sideridispas/Measuring-PCB/README.md

# Measuring-PCB
Voltage, Current, Temperature and Timestamped measurement board with an Atmega328 as main CPU
