sideridispas/Measuring-PCB/3D/board2.brd.stp

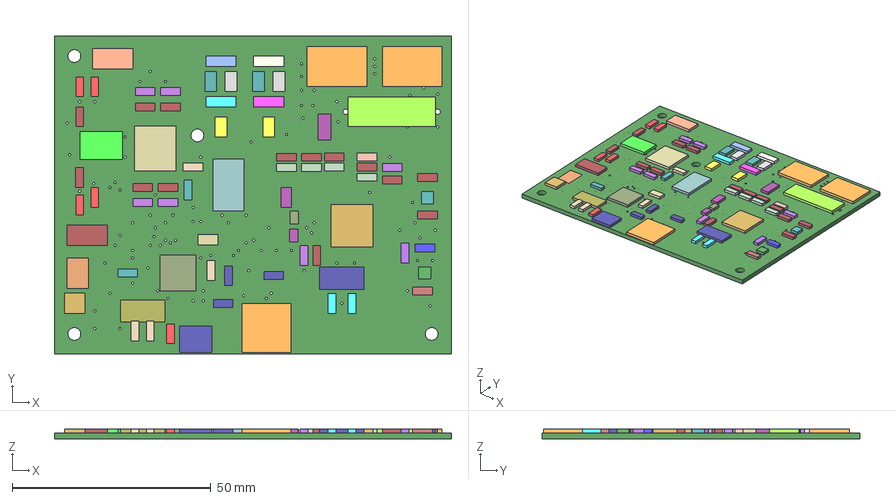
[picture p1: CAD file, 2016-03-25]
3D/board2.brd.stp
100.0 x 80.0 x 2.60 mm
board2.brd_Outline
PHOENIX-TERMINAL-3PIN, PHOENIX-TERMINAL-3PIN_1
SOT95P280X145-6N, ADR3425ARJZ-R7_3
SOP65P780X200-28N, ADS1256IDBT_5
SOIC127P1032X265-16N, ADUM5000ARWZ_7
1X02, AIN6-7_1X02_9
TQFP32-08, ATMEGA328P_TQFP_11
BATTCON_12MM, 3V_13
C3216, 10U_15 x 6
C3216, 0_1U_17 x 14
C3216, 47U_19
C3216, 100P_22 x 4
C3216, 18P_26 x 2
C3216, 1U_47
C3216, 10N_49
C3216, 2_2U_51
C3216, 22P_53 x 4
DS3234, DS3234_58
PAS_5X20, 15A_60
2X3, FEMALE_62
2X04, ISOLATED_CON_2X04_64
1X03, JP1A_1X03_66
1X03, JP1B_1X03_68
1X03, JP2A_1X03_70
1X03, JP2B_1X03_72
SOT95P280X145-5N, LP2985-33DBVT_74
SOIC-16, IC_DIL16-SOIC-16_76
2X04, NON-ISOLATED_CON_2X04_78
HC49U-V, 7_68MHZ_80
HC49U-V, 16MHZ_82
LVK25, 0_005_84
R3216, 4_7K_86 x 5
M3216, 560K_88 x 2
M3216, 5_49M_90 x 2
M3216, 1K_95 x 2
R3216, 100_100 x 3
R3216, 10K_104 x 2
TACTILE-SWITCH-SMD, TAC_SWITCHSMD_108
1X02, RX-TX_1X02_110
SJ, SJ1-RST_SJ_112
SJ, SJ2-SYNC_SJ_114
2TERMINALBLOCK_10MMPITCH, 2PIN_TERMINAL_PCBMOUNT_116 x 2
