sideridispas/Measuring-PCB/(list of files, cad)

Other CAD files:
3D/1X02, AIN6-7_1X02_9.ipt
3D/1X02, RX-TX_1X02_110.ipt
3D/1X03, JP1A_1X03_66.ipt
3D/1X03, JP1B_1X03_68.ipt
3D/1X03, JP2A_1X03_70.ipt
3D/1X03, JP2B_1X03_72.ipt
3D/2TERMINALBLOCK_10MMPITCH, 2PIN_TERMINAL_PCBMOUNT_116.ipt
3D/2X04, ISOLATED_CON_2X04_64.ipt
3D/2X04, NON-ISOLATED_CON_2X04_78.ipt
3D/2X3, FEMALE_62.ipt
3D/Assembly.iam
3D/BATTCON_12MM, 3V_13.ipt
3D/C3216, 0_1U_17.ipt
3D/C3216, 100P_22.ipt
3D/C3216, 10N_49.ipt
3D/C3216, 10U_15.ipt
3D/C3216, 18P_26.ipt
3D/C3216, 1U_47.ipt
3D/C3216, 22P_53.ipt
3D/C3216, 2_2U_51.ipt
3D/C3216, 47U_19.ipt
3D/DS3234, DS3234_58.ipt
3D/HC49U-V, 16MHZ_82.ipt
3D/HC49U-V, 7_68MHZ_80.ipt
3D/IC_names.ipt
3D/LVK25, 0_005_84.ipt
3D/M3216, 1K_95.ipt
3D/M3216, 560K_88.ipt
3D/M3216, 5_49M_90.ipt
3D/MC4_plug.ipt
3D/New3DTry/1X02, RX-TX_1X02_119.ipt
3D/New3DTry/1X02_NO_SILK, AIN6-7_1X02_NO_SILK_9.ipt
3D/New3DTry/1X03, JP1A_1X03_69.ipt
3D/New3DTry/1X03, JP1B_1X03_71.ipt
3D/New3DTry/1X03, JP2A_1X03_73.ipt
3D/New3DTry/1X03, JP2B_1X03_75.ipt
3D/New3DTry/1X04_NO_SILK_ALL_ROUND, D0-D3_1X04_NO_SILK_ALL_ROUND_59.ipt
3D/New3DTry/2X04, ISOLATED_CON_2X04_67.ipt
3D/New3DTry/2X04, NON-ISOLATED_CON_2X04_83.ipt
3D/New3DTry/2X3, FEMALE_65.ipt
3D/New3DTry/BATTCON_12MM, 3V_13.ipt
3D/New3DTry/C3216, 0_1U_17.ipt
3D/New3DTry/C3216, 100P_22.ipt
3D/New3DTry/C3216, 10N_49.ipt
3D/New3DTry/C3216, 10U_15.ipt
3D/New3DTry/C3216, 18P_26.ipt
3D/New3DTry/C3216, 1U_47.ipt
3D/New3DTry/C3216, 22P_53.ipt
3D/New3DTry/C3216, 2_2U_51.ipt
3D/New3DTry/C3216, 47U_19.ipt
3D/New3DTry/CHIPLED_0805, LED1_CHIPLED_0805_77.ipt
3D/New3DTry/DS3234, DS3234_61.ipt
3D/New3DTry/HC49U-V, 16MHZ_87.ipt
3D/New3DTry/HC49U-V, 7_68MHZ_85.ipt
3D/New3DTry/LVK25, 0_005_89.ipt
3D/New3DTry/M3216, 1K_100.ipt
3D/New3DTry/M3216, 560K_93.ipt
3D/New3DTry/M3216, 5_49M_95.ipt
3D/New3DTry/OldVersions/board2.brd.0007.iam
3D/New3DTry/OldVersions/board2.brd.0017.iam
3D/New3DTry/PAS-PHOENIXTERMINAL-2PIN-10_16MM, PAS-PHOENIXTERMINAL2PIN-10_16MM_123.ipt
3D/New3DTry/PAS_5X20, 15A_63.ipt
3D/New3DTry/PHOENIX-TERMINAL-3PIN, PHOENIX-TERMINAL-3PIN_1.ipt
3D/New3DTry/R3216, 100_105.ipt
3D/New3DTry/R3216, 10K_109.ipt
3D/New3DTry/R3216, 1K_113.ipt
3D/New3DTry/R3216, 4_7K_91.ipt
3D/New3DTry/SJ, RST_SJ_117.ipt
3D/New3DTry/SJ, SYNC_SJ_121.ipt
3D/New3DTry/SOIC-16, IC_DIL16-SOIC-16_81.ipt
3D/New3DTry/SOIC127P1032X265-16N, ADUM5000ARWZ_7.ipt
3D/New3DTry/SOP65P780X200-28N, ADS1256IDBT_5.ipt
3D/New3DTry/SOT95P280X145-5N, LP2985-33DBVT_79.ipt
3D/New3DTry/SOT95P280X145-6N, ADR3425ARJZ-R7_3.ipt
3D/New3DTry/TACTILE_SWITCH_TALL, SWITCH-MOMENTARY-2SMD-4_115.ipt
3D/New3DTry/TQFP32-08, ATMEGA328P_TQFP_11.ipt
3D/New3DTry/board2.brd.iam
3D/New3DTry/board2.brd_Outline.ipt
3D/OldVersions/Assembly.0001.iam
3D/OldVersions/board2.brd.0001.ipt
3D/OldVersions/board2.brd.0002.iam
3D/OldVersions/box_base.0001.ipt
3D/OldVersions/fuse.0001.ipt
3D/OldVersions/headers.0001.ipt
3D/PAS_5X20, 15A_60.ipt
3D/PHOENIX-TERMINAL-3PIN, PHOENIX-TERMINAL-3PIN_1.ipt
3D/R3216, 100_100.ipt
3D/R3216, 10K_104.ipt
3D/R3216, 4_7K_86.ipt
3D/SJ, SJ1-RST_SJ_112.ipt
3D/SJ, SJ2-SYNC_SJ_114.ipt
3D/SOIC-16, IC_DIL16-SOIC-16_76.ipt
3D/SOIC127P1032X265-16N, ADUM5000ARWZ_7.ipt
3D/SOP65P780X200-28N, ADS1256IDBT_5.ipt
3D/SOT95P280X145-5N, LP2985-33DBVT_74.ipt
3D/SOT95P280X145-6N, ADR3425ARJZ-R7_3.ipt
3D/TACTILE-SWITCH-SMD, TAC_SWITCHSMD_108.ipt
3D/TQFP32-08, ATMEGA328P_TQFP_11.ipt
3D/board2.brd.iam
3D/board2.brd.ipt
3D/board2.brd_Outline.ipt
3D/box_base.ipt
3D/button.ipt
3D/connectors.ipt
3D/crystals.ipt
3D/fuse.ipt
3D/headers.ipt
