sideridispas/Measuring-PCB/boardv2.3_schematic.pdf

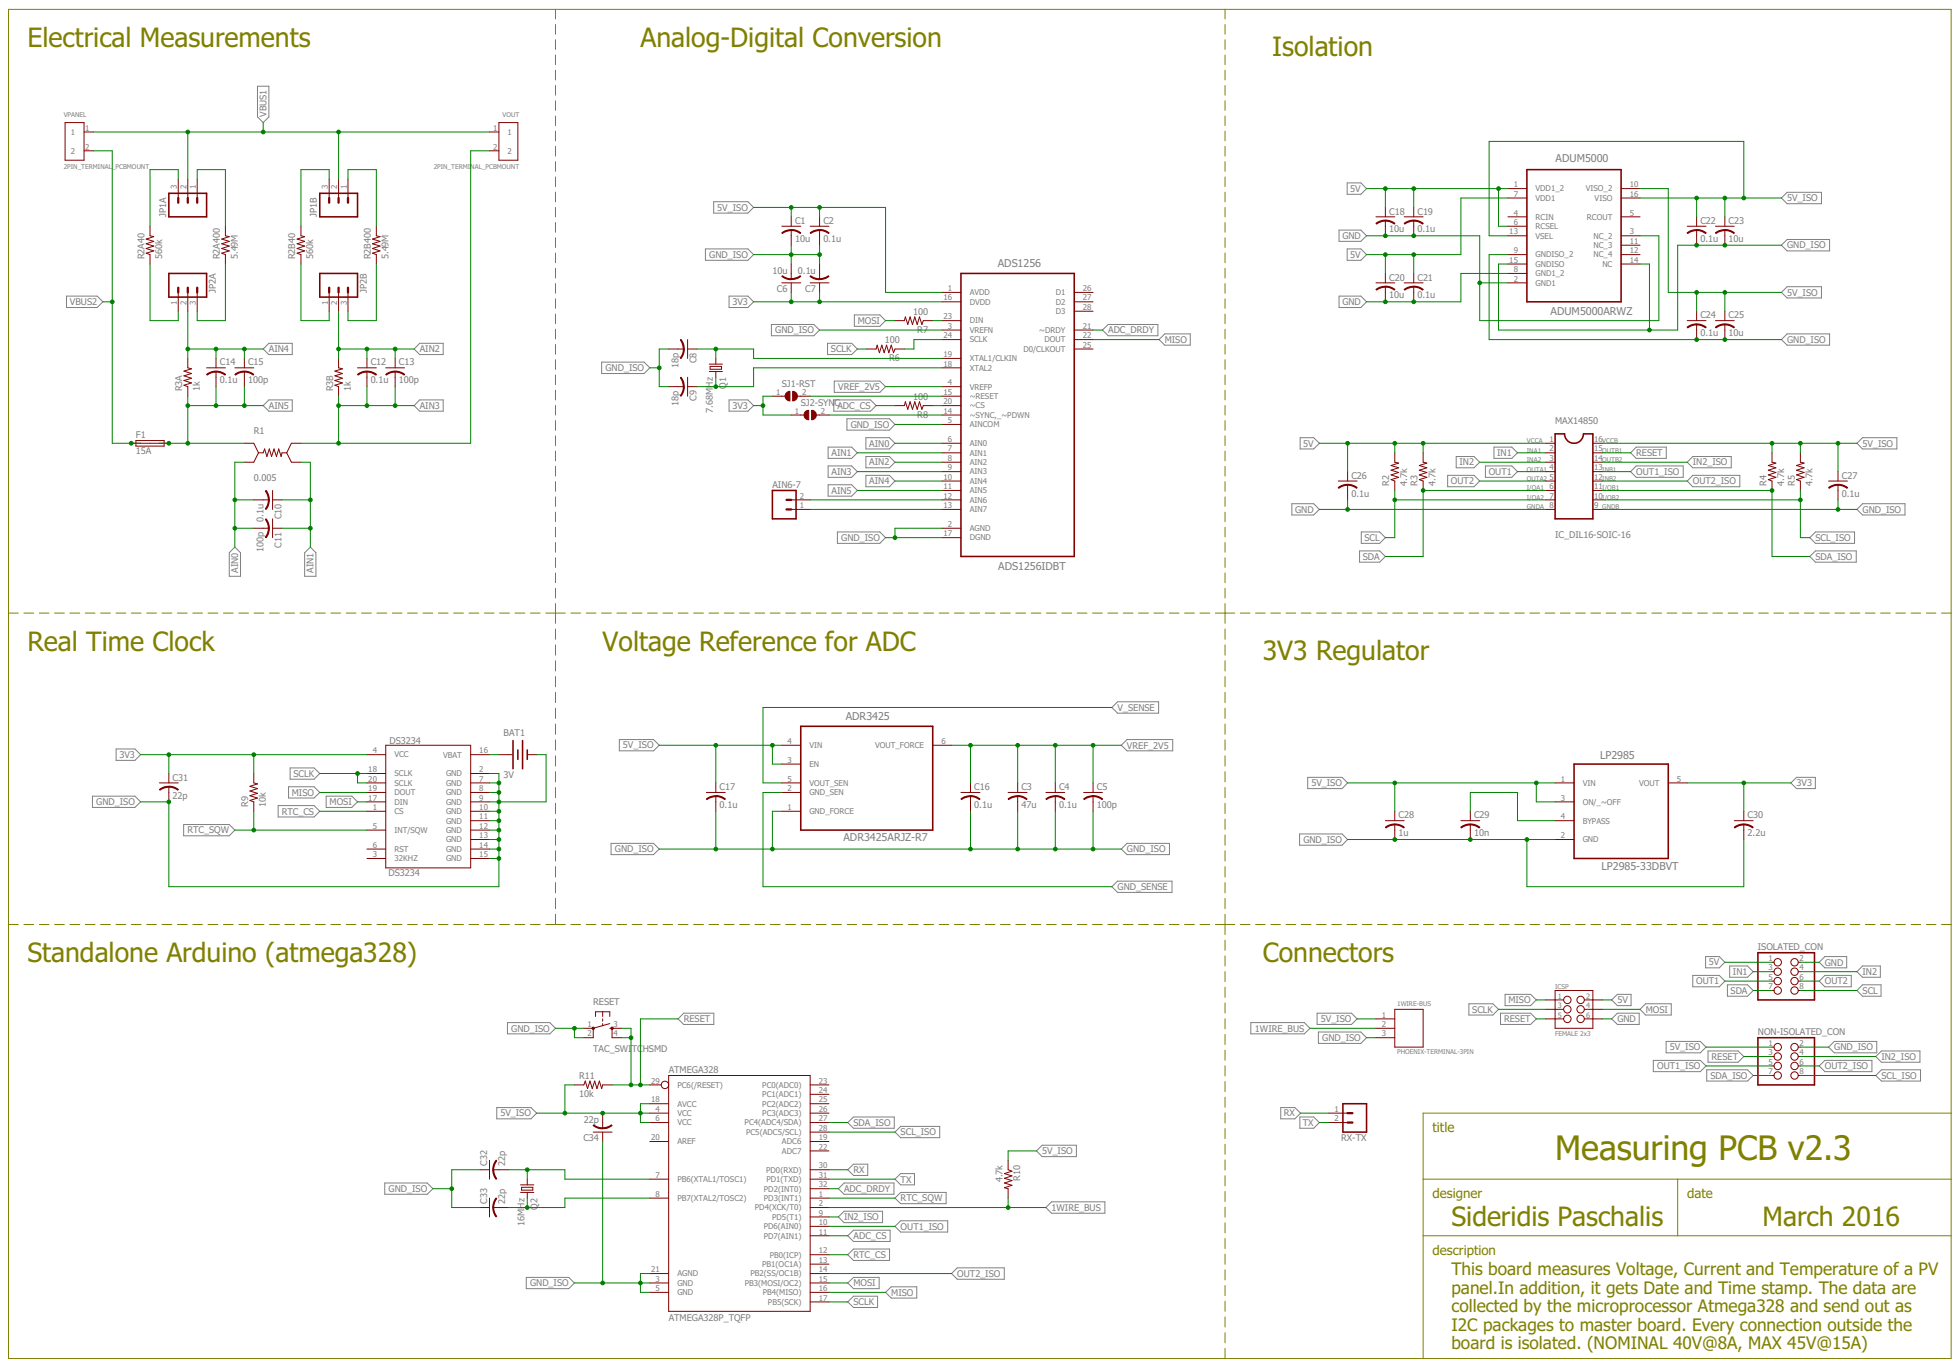
[picture p2: page 1]

SDA | 7 8 | SCL

title designer Sideridis Paschalis

description This board measures Voltage, Current and Temperature of a PV

panel.In addition, it gets Date and Time stamp. The data are
collected by the microprocessor Atmega328 and send out as
I2C packages to master board. Every connection outside the board is isolated. (NOMINAL 40V@8A, MAX 45V@15A)
