sideridispas/Measuring-PCB/board_v2.3.pdf

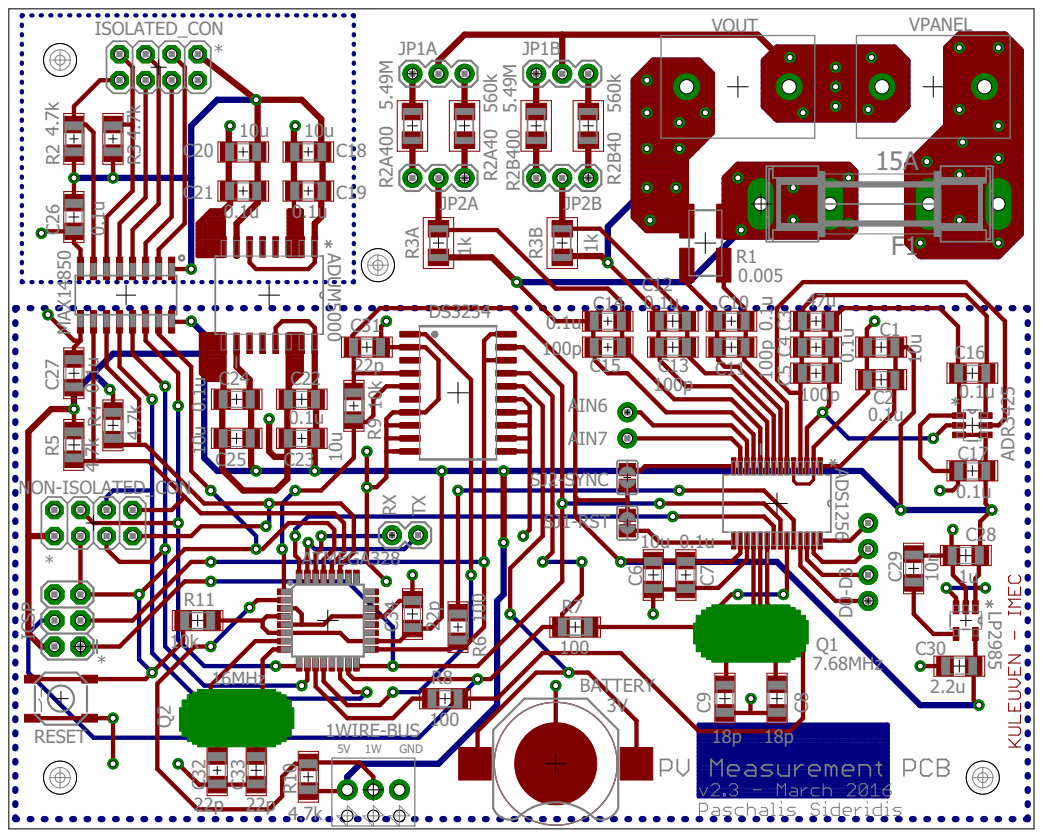
[picture p3: page 1]
