sideridispas/Measuring-PCB/board_v2.1.pdf

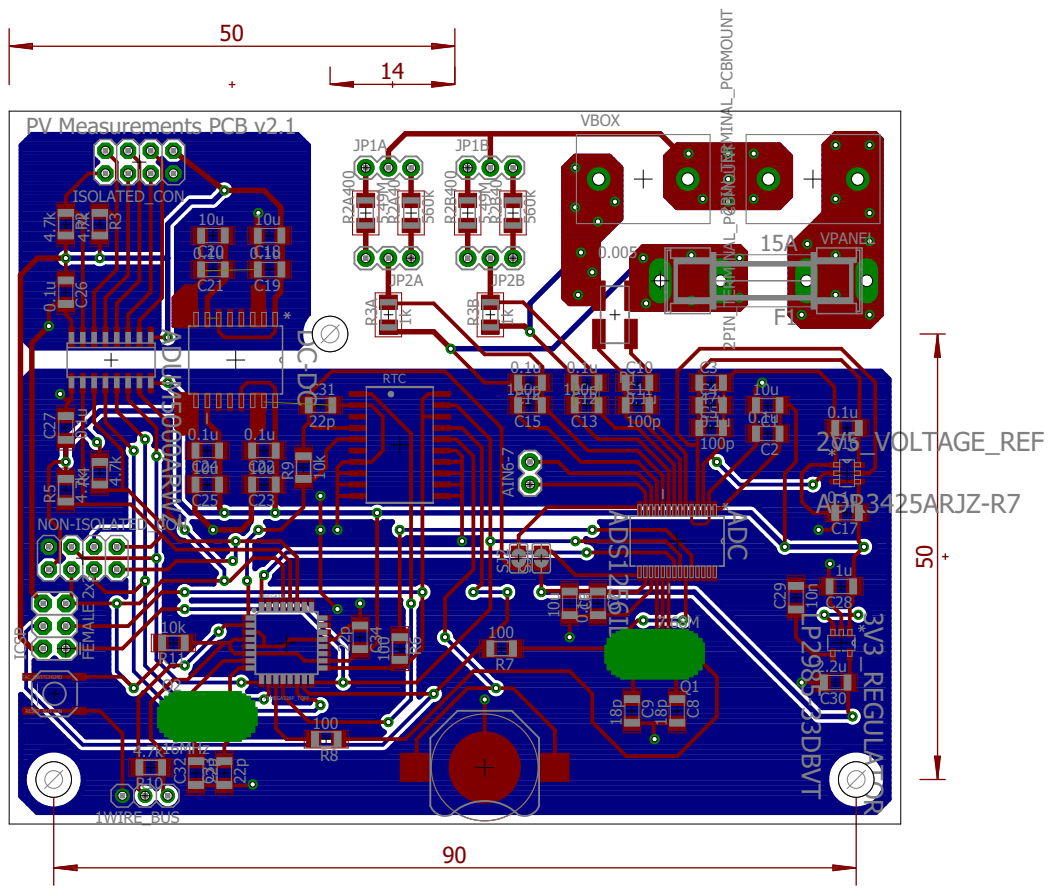
[picture p4: page 1]

ISOLATED_CON

C31 | | | 100p | 100p | 0.1u | C4C5 47u | 10u
22p | 100p | 0.1u | 0.1u | 0.1u

RTC | R1

C22 C23 C24 C25
10u | | 10u

4.7k16MHz
