sideridispas/Measuring-PCB/board_v2.0.pdf

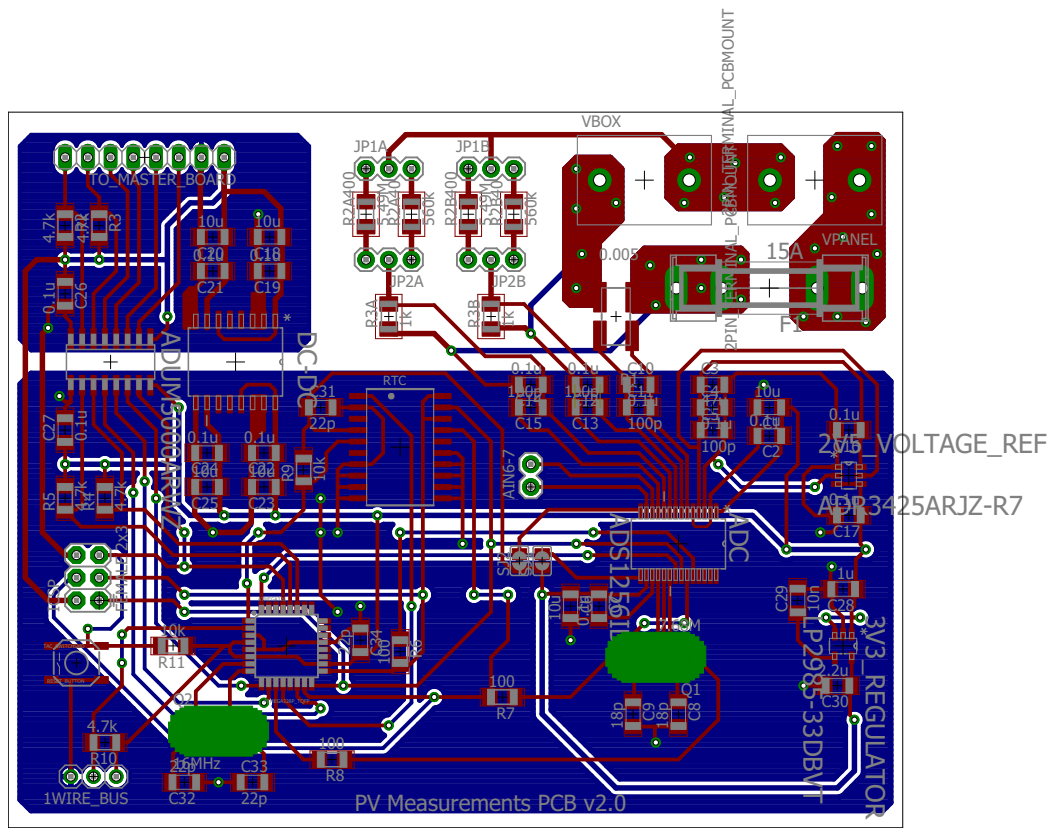
[picture p5: page 1]

TO_MASTER_BOARD

RTC | R1

C22 C23 C24 C25
10u | | 10u

ATMEGA328 | C28
