sideridispas/Measuring-PCB/board2.brd

## EAGLE design board2.brd (2016-04-07)

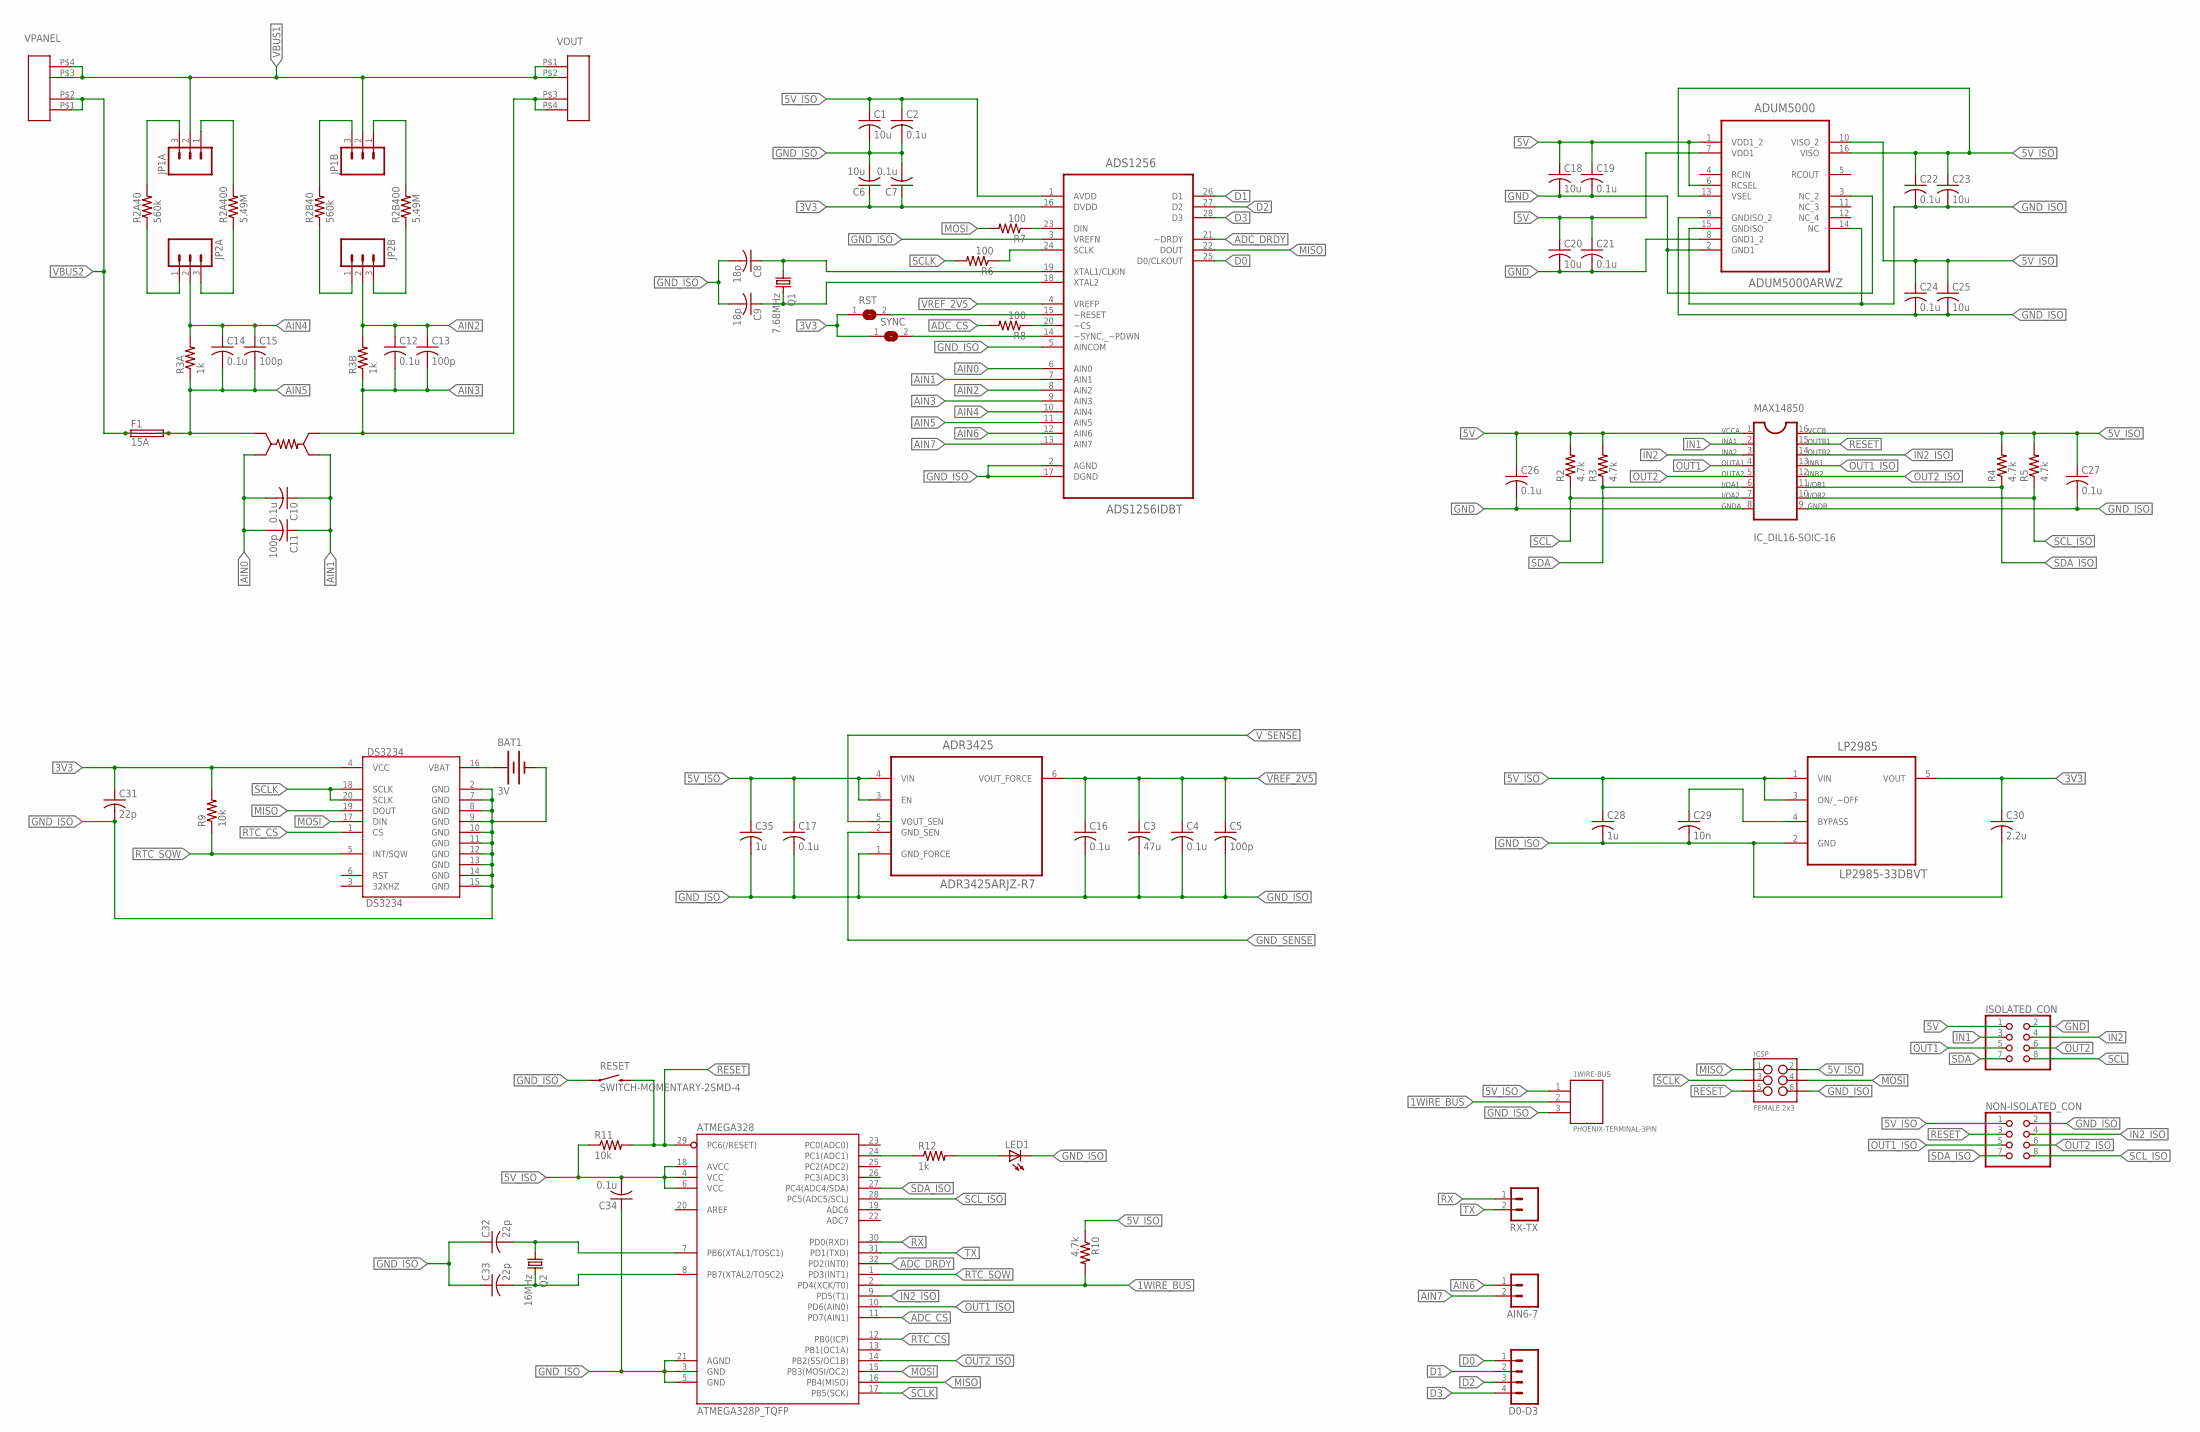
[picture p7: schematic board2.sch]

Parts:
1WIRE-BUS: PHOENIX-TERMINAL-3PIN
ADR3425: ADR3425ARJZ-R7; SOT95P280X145-6N
ADS1256: ADS1256IDBT; SOP65P780X200-28N
ADUM5000: ADUM5000ARWZ; SOIC127P1032X265-16N
AIN6-7: M021X02_NO_SILK; 1X02_NO_SILK
ATMEGA328: ATMEGA328P_TQFP; TQFP32-08
BAT1: 3V; BATTCON_12MM
C1, C6, C18, C20, C23, C25: 10u; C3216
C2, C4, C7, C10, C12, C14, C16, C17, C19, C21, C22, C24, C26, C27, C34: 0.1u; C3216
C3: 47u; C3216
C5, C11, C13, C15: 100p; C3216
C8, C9: 18p; C3216
C28, C35: 1u; C3216
C29: 10n; C3216
C30: 2.2u; C3216
C31, C32, C33: 22p; C3216
D0-D3: M04NO_SILK_ALL_ROUND; 1X04_NO_SILK_ALL_ROUND
DS3234: DS3234
F1: 15A; PAS_5X20
ICSP: FEMALE 2x3; 2X3
ISOLATED_CON: PINHD-2X4; 2X04
JP1A, JP1B, JP2A, JP2B: M03PTH; 1X03
LED1: LEDCHIPLED_0805; CHIPLED_0805
LP2985: LP2985-33DBVT; SOT95P280X145-5N
MAX14850: IC_DIL16-SOIC-16; SOIC-16
NON-ISOLATED_CON: PINHD-2X4; 2X04
Q1: 7.68MHz; HC49U-V
Q2: 16MHz; HC49U-V
R1: 0.005; LVK25
R2, R3, R4, R5, R10: 4.7k; R3216
R2A40, R2B40: 560k; M3216
R2A400, R2B400: 5.49M; M3216
R3A, R3B: 1k; M3216
R6, R7, R8: 100; R3216
R9, R11: 10k; R3216
R12: 1k; R3216
RESET: SWITCH-MOMENTARY-2SMD-4; TACTILE_SWITCH_TALL
RST: SJ
RX-TX: M02PTH; 1X02
SYNC: SJ
VOUT: PAS-PHOENIXTERMINAL2PIN-10.16MM; PAS-PHOENIXTERMINAL-2PIN-10.16MM
VPANEL: PAS-PHOENIXTERMINAL2PIN-10.16MM; PAS-PHOENIXTERMINAL-2PIN-10.16MM

Connections:
1WIRE_BUS: 1WIRE-BUS.2, ATMEGA328.2 (PD4(XCK/T0)), R10.2
3V3: ADS1256.16 (DVDD), C6.1, C7.1, C30.1, C31.1, DS3234.4 (VCC), LP2985.5 (VOUT), R9.2, RST.1, SYNC.1
5V: ADUM5000.1 (VDD1_2), ADUM5000.6 (RCSEL), ADUM5000.7 (VDD1), C18.1, C19.1, C20.1, C21.1, C26.1, ISOLATED_CON.1, MAX14850.1 (VCCA), R2.2, R3.2
5V_ISO: 1WIRE-BUS.1, ADR3425.3 (EN), ADR3425.4 (VIN), ADS1256.1 (AVDD), ADUM5000.10 (VISO_2), ADUM5000.13 (VSEL), ADUM5000.16 (VISO), ATMEGA328.4 (VCC), ATMEGA328.6 (VCC), ATMEGA328.18 (AVCC), C1.1, C2.1, C17.1, C22.1, C23.1, C24.1, C25.1, C27.1, C28.1, C34.2, C35.1, ICSP.2, LP2985.1 (VIN), LP2985.3 (ON/_~OFF), MAX14850.16 (VCCB), NON-ISOLATED_CON.1, R4.2, R5.2, R10.1, R11.1
ADC_CS: ATMEGA328.11 (PD7(AIN1)), R8.2
ADC_DRDY: ADS1256.21 (~DRDY), ATMEGA328.32 (PD2(INT0))
AIN0: ADS1256.6 (AIN0), C10.2, C11.2, R1.INV (2)
AIN1: ADS1256.7 (AIN1), C10.1, C11.1, R1.OUTV (4)
AIN2: ADS1256.8 (AIN2), C12.1, C13.1, JP2B.2, R3B.2
AIN3: ADS1256.9 (AIN3), C12.2, C13.2, R1.OUTI (3), R3B.1, VOUT.P$3, VOUT.P$4
AIN4: ADS1256.10 (AIN4), C14.1, C15.1, JP2A.2, R3A.2
AIN5: ADS1256.11 (AIN5), C14.2, C15.2, F1.2A, F1.2B, R1.INI (1), R3A.1
AIN6: ADS1256.12 (AIN6), AIN6-7.1
AIN7: ADS1256.13 (AIN7), AIN6-7.2
D0: ADS1256.25 (D0/CLKOUT), D0-D3.1
D1: ADS1256.26 (D1), D0-D3.2
D2: ADS1256.27 (D2), D0-D3.3
D3: ADS1256.28 (D3), D0-D3.4
GND: ADUM5000.2 (GND1), ADUM5000.3 (NC_2), ADUM5000.8 (GND1_2), C18.2, C19.2, C20.2, C21.2, C26.2, ISOLATED_CON.2, MAX14850.8 (GNDA)
GND_ISO: 1WIRE-BUS.3, ADR3425.1 (GND_FORCE), ADS1256.2 (AGND), ADS1256.3 (VREFN), ADS1256.5 (AINCOM), ADS1256.17 (DGND), ADUM5000.9 (GNDISO_2), ADUM5000.14 (NC), ADUM5000.15 (GNDISO), ATMEGA328.3 (GND), ATMEGA328.5 (GND), ATMEGA328.21 (AGND), BAT1.GND (-), C1.2, C2.2, C3.2, C4.2, C5.2, C6.2, C7.2, C8.2, C9.2, C16.2, C17.2, C22.2, C23.2, C24.2, C25.2, C27.2, C28.2, C29.2, C30.2, C31.2, C32.1, C33.1, C34.1, C35.2, DS3234.2 (GND), DS3234.7 (GND), DS3234.8 (GND), DS3234.9 (GND), DS3234.10 (GND), DS3234.11 (GND), DS3234.12 (GND), DS3234.13 (GND), DS3234.14 (GND), DS3234.15 (GND), ICSP.6, LED1.C, LP2985.2 (GND), MAX14850.9 (GNDB), NON-ISOLATED_CON.2, RESET.A2 (1)
GND_SENSE: ADR3425.2 (GND_SEN)
IN1: ISOLATED_CON.3, MAX14850.2 (INA1)
IN2: ISOLATED_CON.4, MAX14850.3 (INA2)
IN2_ISO: ATMEGA328.9 (PD5(T1)), MAX14850.14 (OUTB2), NON-ISOLATED_CON.4
MISO: ADS1256.22 (DOUT), ATMEGA328.16 (PB4(MISO)), DS3234.19 (DOUT), ICSP.1
MOSI: ATMEGA328.15 (PB3(MOSI/OC2)), DS3234.17 (DIN), ICSP.4, R7.2
unnamed: ADS1256.24 (SCLK), R6.1
unnamed: JP1A.3, R2A40.2
unnamed: JP1A.1, R2A400.2
unnamed: JP2A.3, R2A400.1
unnamed: JP2A.1, R2A40.1
unnamed: ATMEGA328.8 (PB7(XTAL2/TOSC2)), C33.2, Q2.2
unnamed: JP1B.3, R2B40.2
unnamed: JP1B.1, R2B400.2
unnamed: JP2B.3, R2B400.1
unnamed: JP2B.1, R2B40.1
unnamed: ADS1256.19 (XTAL1/CLKIN), C8.1, Q1.1
unnamed: ADS1256.18 (XTAL2), C9.1, Q1.2
unnamed: ATMEGA328.7 (PB6(XTAL1/TOSC1)), C32.2, Q2.1
unnamed: ADS1256.23 (DIN), R7.1
unnamed: BAT1.PWR@1 (+), DS3234.16 (VBAT)
unnamed: ADS1256.20 (~CS), R8.1
unnamed: ADS1256.15 (~RESET), RST.2
unnamed: ATMEGA328.24 (PC1(ADC1)), R12.1
unnamed: LED1.A, R12.2
unnamed: ADS1256.14 (~SYNC,_~PDWN), SYNC.2
unnamed: C29.1, LP2985.4 (BYPASS)
OUT1: ISOLATED_CON.5, MAX14850.4 (OUTA1)
OUT1_ISO: ATMEGA328.10 (PD6(AIN0)), MAX14850.13 (INB1), NON-ISOLATED_CON.5
OUT2: ISOLATED_CON.6, MAX14850.5 (OUTA2)
OUT2_ISO: ATMEGA328.14 (PB2(SS/OC1B)), MAX14850.12 (INB2), NON-ISOLATED_CON.6
RESET: ATMEGA328.29 (PC6(/RESET)), ICSP.5, MAX14850.15 (OUTB1), NON-ISOLATED_CON.3, R11.2, RESET.B2 (2)
RTC_CS: ATMEGA328.12 (PB0(ICP)), DS3234.1 (CS)
RTC_SQW: ATMEGA328.1 (PD3(INT1)), DS3234.5 (INT/SQW), R9.1
RX: ATMEGA328.30 (PD0(RXD)), RX-TX.1
SCL: ISOLATED_CON.8, MAX14850.7 (I/OA2), R2.1
SCLK: ATMEGA328.17 (PB5(SCK)), DS3234.18 (SCLK), DS3234.20 (SCLK), ICSP.3, R6.2
SCL_ISO: ATMEGA328.28 (PC5(ADC5/SCL)), MAX14850.10 (I/OB2), NON-ISOLATED_CON.8, R5.1
SDA: ISOLATED_CON.7, MAX14850.6 (I/OA1), R3.1
SDA_ISO: ATMEGA328.27 (PC4(ADC4/SDA)), MAX14850.11 (I/OB1), NON-ISOLATED_CON.7, R4.1
TX: ATMEGA328.31 (PD1(TXD)), RX-TX.2
VBUS1: JP1A.2, JP1B.2, VOUT.P$1, VOUT.P$2, VPANEL.P$3, VPANEL.P$4
VBUS2: F1.1A, F1.1B, VPANEL.P$1, VPANEL.P$2
VREF_2V5: ADR3425.6 (VOUT_FORCE), ADS1256.4 (VREFP), C3.1, C4.1, C5.1, C16.1
V_SENSE: ADR3425.5 (VOUT_SEN)

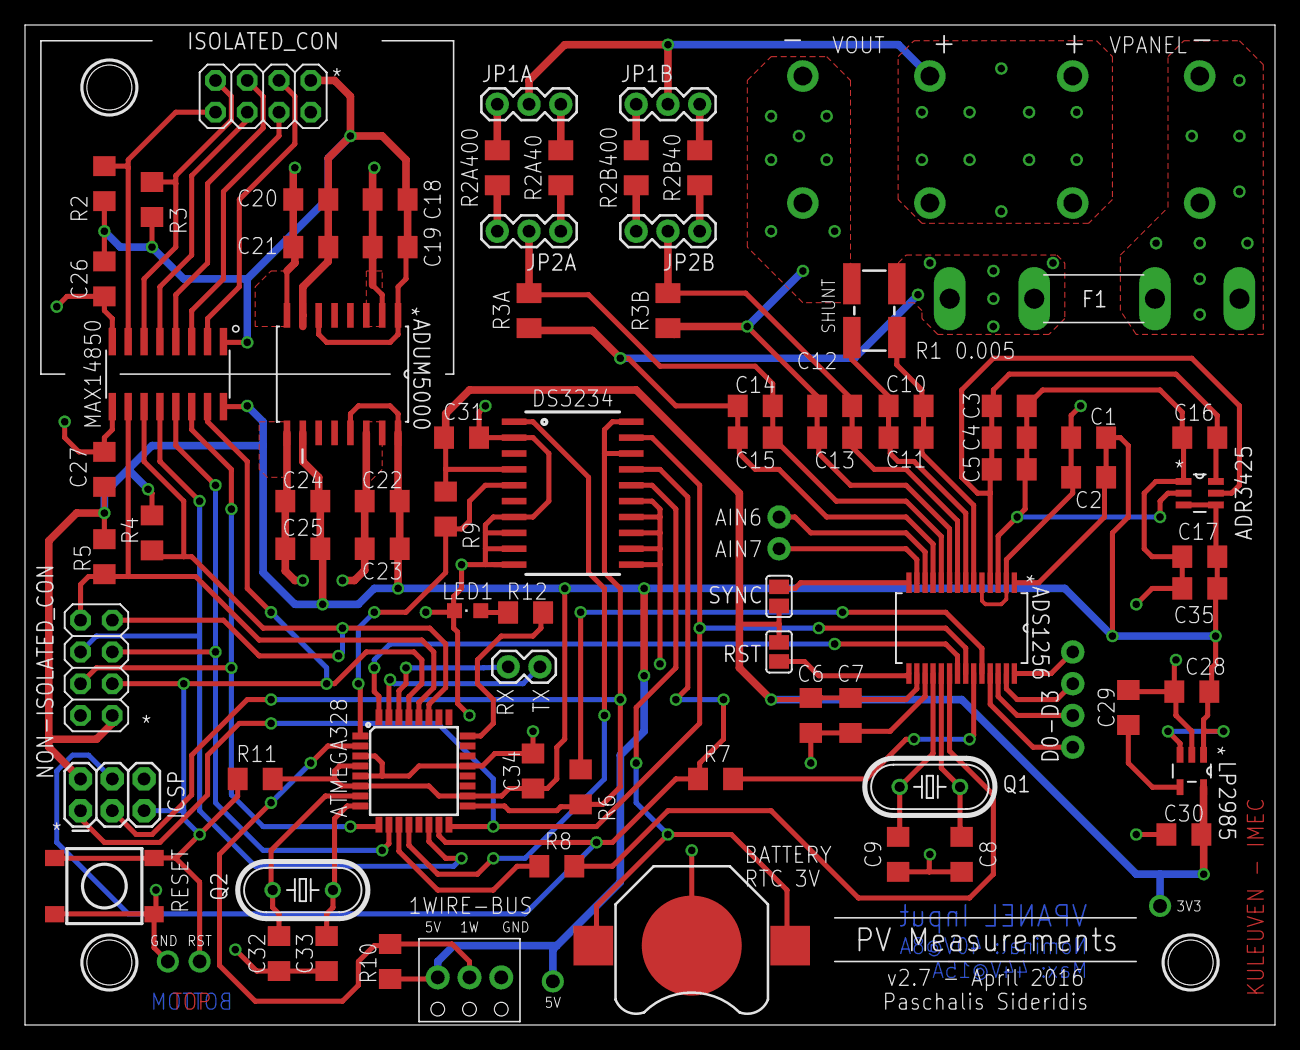
[picture p8: board board2.brd from above]

Board: 2 copper layers, 100.0 x 80.0 mm, 81 parts (0 on the bottom side), 63 nets.
