sideridispas/Measuring-PCB/board1.brd

## EAGLE design board1.brd (2016-03-18)

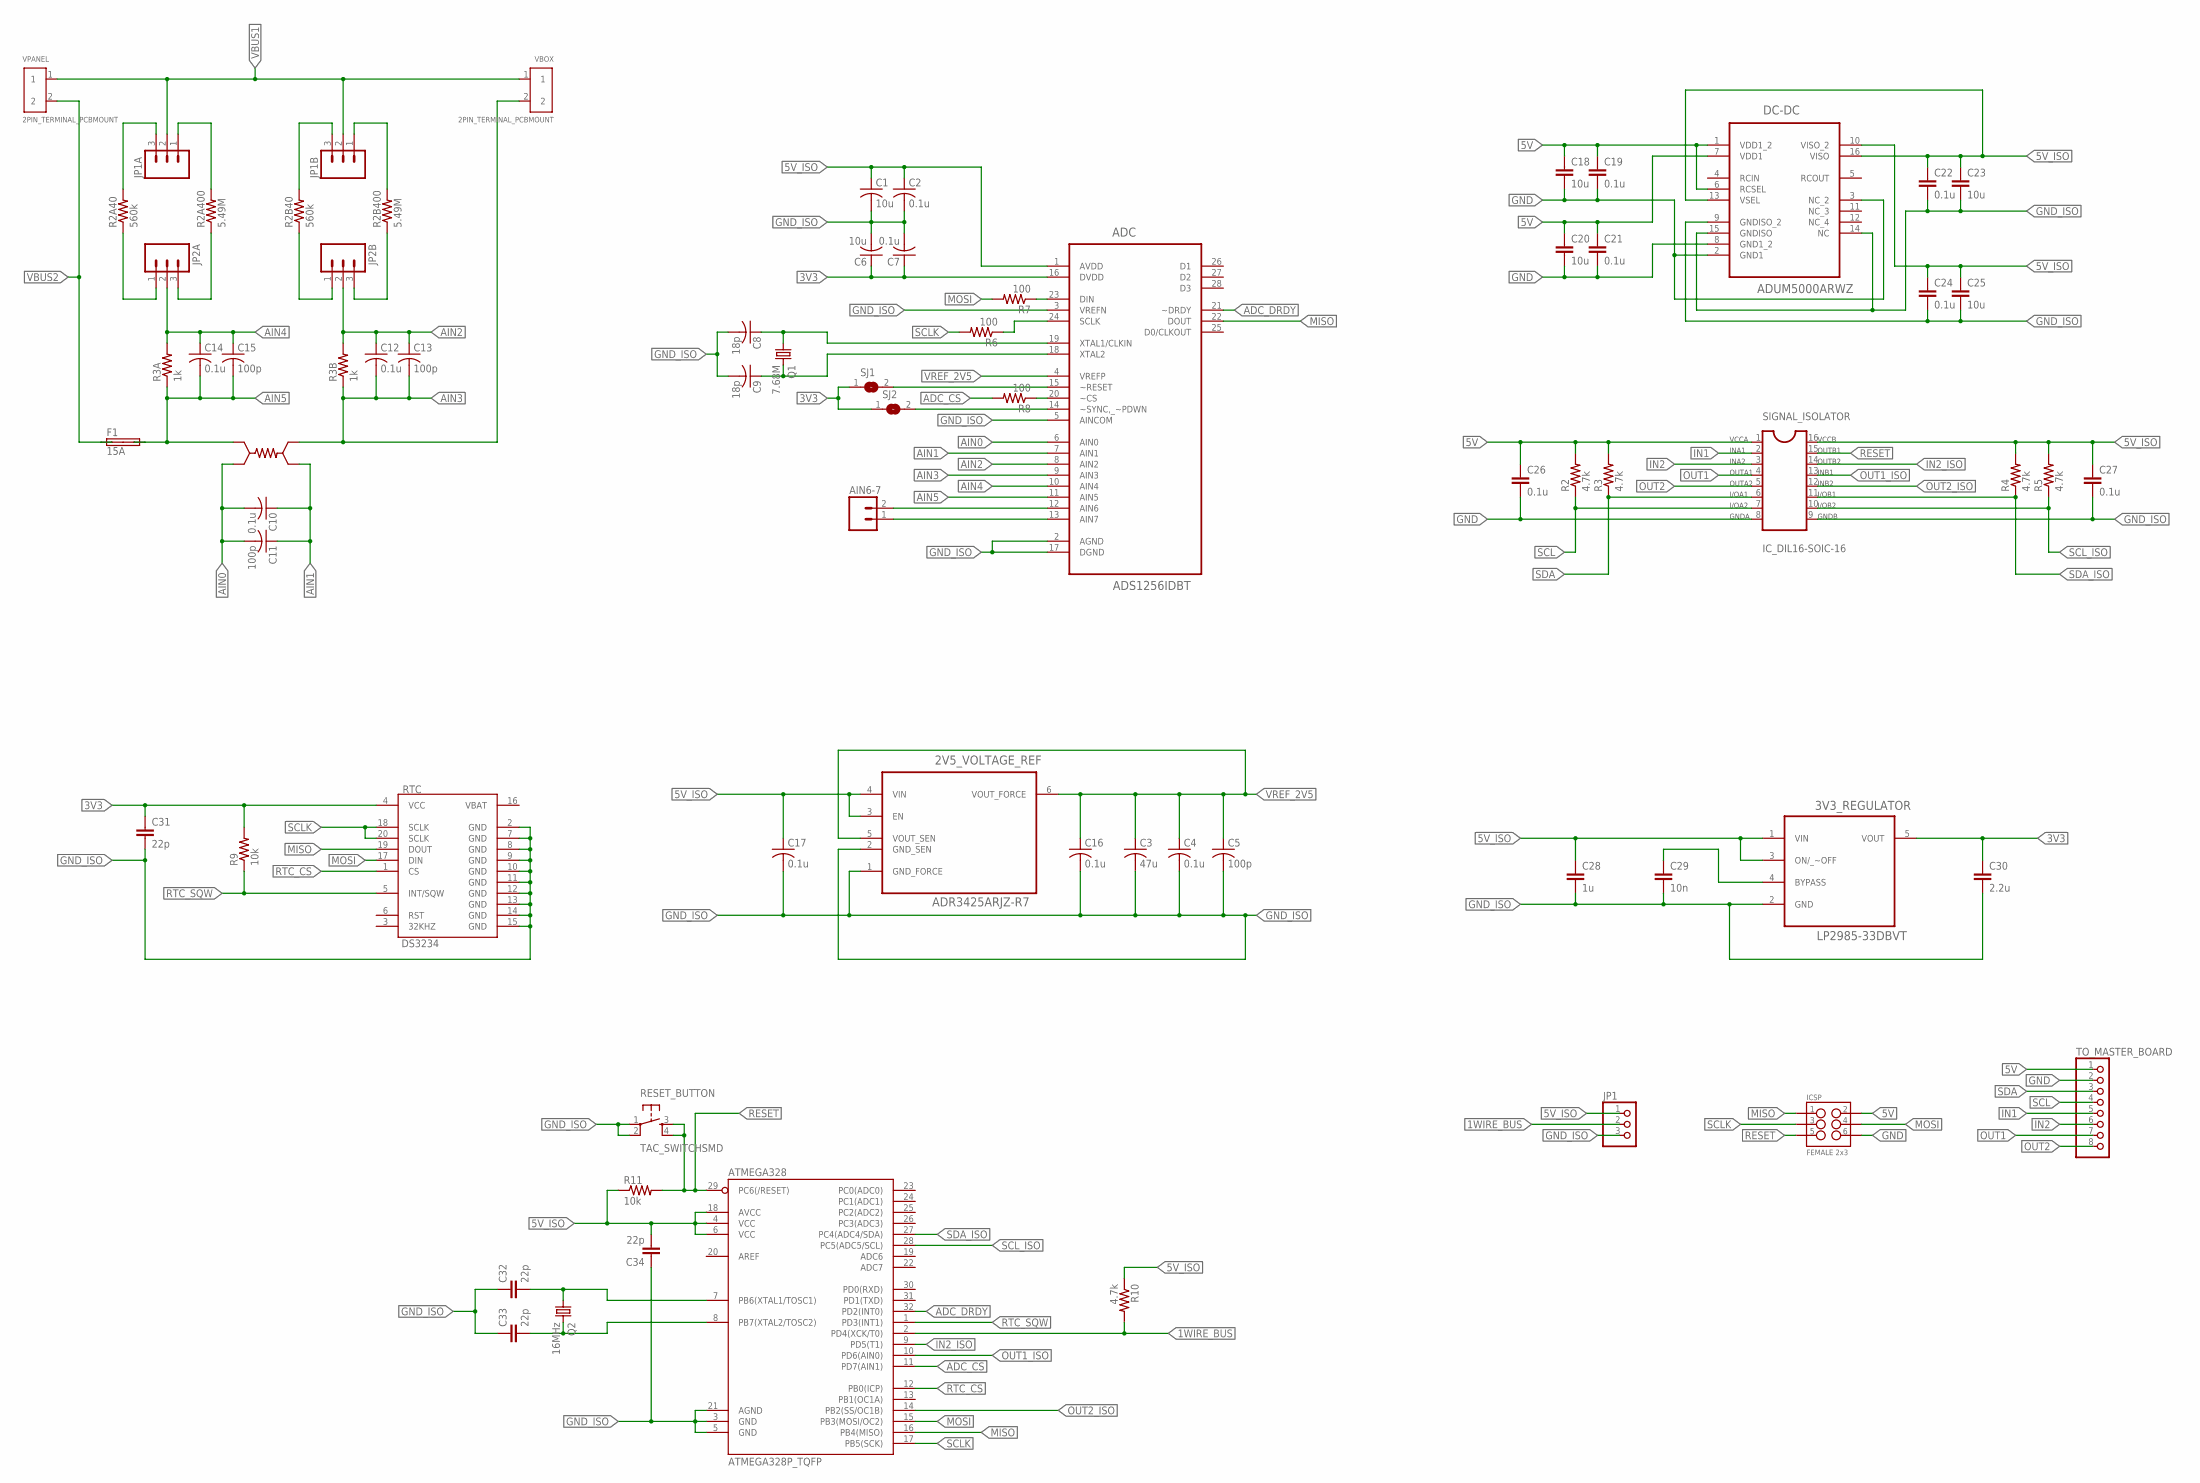
[picture p9: schematic board1.sch]

Parts:
2V5_VOLTAGE_REF: ADR3425ARJZ-R7; SOT95P280X145-6N
3V3_REGULATOR: LP2985-33DBVT; SOT95P280X145-5N
ADC: ADS1256IDBT; SOP65P780X200-28N
AIN6-7: M02PTH; 1X02
ATMEGA328: ATMEGA328P_TQFP; TQFP32-08
C1, C6: 10u; C3216
C2, C4, C7, C10, C12, C14, C16, C17: 0.1u; C3216
C3: 47u; C3216
C5, C11, C13, C15: 100p; C3216
C8, C9: 18p; C3216
C18, C20, C23, C25: 10u; 1206
C19, C21, C22, C24, C26, C27: 0.1u; 1206
C28: 1u; 1206
C29: 10n; 1206
C30: 2.2u; 1206
C31, C32, C33, C34: 22p; 1206
DC-DC: ADUM5000ARWZ; SOIC127P1032X265-16N
F1: 15A; SHK20L
ICSP: FEMALE 2x3; 2X3
JP1: PINHD-1X3; 1X03
JP1A, JP1B, JP2A, JP2B: M03PTH; 1X03
Q1: 7.68M; HC49U-V
Q2: 16MHz; HC49U-V
R1: 0.005; LVK25
R2, R3, R4, R5, R10: 4.7k; 1206
R2A40, R2B40: 560k; M3216
R2A400, R2B400: 5.49M; M3216
R3A, R3B: 1k; M3216
R6, R7, R8: 100; M3216
R9, R11: 10k; 1206
RESET_BUTTON: TAC_SWITCHSMD; TACTILE-SWITCH-SMD
RTC: DS3234
SIGNAL_ISOLATOR: IC_DIL16-SOIC-16; SOIC-16
SJ1, SJ2: SJ
TO_MASTER_BOARD: PINHD-1X8/90; 1X08/90
VBOX: 2PIN_TERMINAL_PCBMOUNT; 2TERMINALBLOCK_10MMPITCH
VPANEL: 2PIN_TERMINAL_PCBMOUNT; 2TERMINALBLOCK_10MMPITCH

Connections:
1WIRE_BUS: ATMEGA328.2 (PD4(XCK/T0)), JP1.2, R10.2
3V3: 3V3_REGULATOR.5 (VOUT), ADC.16 (DVDD), C6.1, C7.1, C30.1, C31.1, R9.2, RTC.4 (VCC), SJ1.1, SJ2.1
5V: C18.1, C19.1, C20.1, C21.1, C26.1, DC-DC.1 (VDD1_2), DC-DC.6 (RCSEL), DC-DC.7 (VDD1), ICSP.2, R2.2, R3.2, SIGNAL_ISOLATOR.1 (VCCA), TO_MASTER_BOARD.1
5V_ISO: 2V5_VOLTAGE_REF.3 (EN), 2V5_VOLTAGE_REF.4 (VIN), 3V3_REGULATOR.1 (VIN), 3V3_REGULATOR.3 (ON/_~OFF), ADC.1 (AVDD), ATMEGA328.4 (VCC), ATMEGA328.6 (VCC), ATMEGA328.18 (AVCC), C1.1, C2.1, C17.1, C22.1, C23.1, C24.1, C25.1, C27.1, C28.1, C34.2, DC-DC.10 (VISO_2), DC-DC.13 (VSEL), DC-DC.16 (VISO), JP1.1, R4.2, R5.2, R10.1, R11.1, SIGNAL_ISOLATOR.16 (VCCB)
ADC_CS: ATMEGA328.11 (PD7(AIN1)), R8.2
ADC_DRDY: ADC.21 (~DRDY), ATMEGA328.32 (PD2(INT0))
AIN0: ADC.6 (AIN0), C10.2, C11.2, R1.INV (2)
AIN1: ADC.7 (AIN1), C10.1, C11.1, R1.OUTV (4)
AIN2: ADC.8 (AIN2), C12.1, C13.1, JP2B.2, R3B.2
AIN3: ADC.9 (AIN3), C12.2, C13.2, R1.OUTI (3), R3B.1, VBOX.2
AIN4: ADC.10 (AIN4), C14.1, C15.1, JP2A.2, R3A.2
AIN5: ADC.11 (AIN5), C14.2, C15.2, F1.2A, F1.2B, R1.INI (1), R3A.1
GND: C18.2, C19.2, C20.2, C21.2, C26.2, DC-DC.2 (GND1), DC-DC.3 (NC_2), DC-DC.8 (GND1_2), ICSP.6, SIGNAL_ISOLATOR.8 (GNDA), TO_MASTER_BOARD.2
GND_ISO: 2V5_VOLTAGE_REF.1 (GND_FORCE), 2V5_VOLTAGE_REF.2 (GND_SEN), 3V3_REGULATOR.2 (GND), ADC.2 (AGND), ADC.3 (VREFN), ADC.5 (AINCOM), ADC.17 (DGND), ATMEGA328.3 (GND), ATMEGA328.5 (GND), ATMEGA328.21 (AGND), C1.2, C2.2, C3.2, C4.2, C5.2, C6.2, C7.2, C8.2, C9.2, C16.2, C17.2, C22.2, C23.2, C24.2, C25.2, C27.2, C28.2, C29.2, C30.2, C31.2, C32.1, C33.1, C34.1, DC-DC.9 (GNDISO_2), DC-DC.14 (NC), DC-DC.15 (GNDISO), JP1.3, RESET_BUTTON.1, RESET_BUTTON.2, RTC.2 (GND), RTC.7 (GND), RTC.8 (GND), RTC.9 (GND), RTC.10 (GND), RTC.11 (GND), RTC.12 (GND), RTC.13 (GND), RTC.14 (GND), RTC.15 (GND), SIGNAL_ISOLATOR.9 (GNDB)
IN1: SIGNAL_ISOLATOR.2 (INA1), TO_MASTER_BOARD.5
IN2: SIGNAL_ISOLATOR.3 (INA2), TO_MASTER_BOARD.6
IN2_ISO: ATMEGA328.9 (PD5(T1)), SIGNAL_ISOLATOR.14 (OUTB2)
MISO: ADC.22 (DOUT), ATMEGA328.16 (PB4(MISO)), ICSP.1, RTC.19 (DOUT)
MOSI: ATMEGA328.15 (PB3(MOSI/OC2)), ICSP.4, R7.2, RTC.17 (DIN)
unnamed: ADC.24 (SCLK), R6.1
unnamed: JP1A.3, R2A40.2
unnamed: JP1A.1, R2A400.2
unnamed: JP2A.3, R2A400.1
unnamed: JP2A.1, R2A40.1
unnamed: ATMEGA328.8 (PB7(XTAL2/TOSC2)), C33.2, Q2.2
unnamed: JP1B.3, R2B40.2
unnamed: JP1B.1, R2B400.2
unnamed: JP2B.3, R2B400.1
unnamed: JP2B.1, R2B40.1
unnamed: ADC.19 (XTAL1/CLKIN), C8.1, Q1.1
unnamed: ADC.18 (XTAL2), C9.1, Q1.2
unnamed: ATMEGA328.7 (PB6(XTAL1/TOSC1)), C32.2, Q2.1
unnamed: ADC.23 (DIN), R7.1
unnamed: ADC.20 (~CS), R8.1
unnamed: ADC.15 (~RESET), SJ1.2
unnamed: ADC.12 (AIN6), AIN6-7.2
unnamed: ADC.13 (AIN7), AIN6-7.1
unnamed: ADC.14 (~SYNC,_~PDWN), SJ2.2
unnamed: 3V3_REGULATOR.4 (BYPASS), C29.1
OUT1: SIGNAL_ISOLATOR.4 (OUTA1), TO_MASTER_BOARD.7
OUT1_ISO: ATMEGA328.10 (PD6(AIN0)), SIGNAL_ISOLATOR.13 (INB1)
OUT2: SIGNAL_ISOLATOR.5 (OUTA2), TO_MASTER_BOARD.8
OUT2_ISO: ATMEGA328.14 (PB2(SS/OC1B)), SIGNAL_ISOLATOR.12 (INB2)
RESET: ATMEGA328.29 (PC6(/RESET)), ICSP.5, R11.2, RESET_BUTTON.3, RESET_BUTTON.4, SIGNAL_ISOLATOR.15 (OUTB1)
RTC_CS: ATMEGA328.12 (PB0(ICP)), RTC.1 (CS)
RTC_SQW: ATMEGA328.1 (PD3(INT1)), R9.1, RTC.5 (INT/SQW)
SCL: R2.1, SIGNAL_ISOLATOR.7 (I/OA2), TO_MASTER_BOARD.4
SCLK: ATMEGA328.17 (PB5(SCK)), ICSP.3, R6.2, RTC.18 (SCLK), RTC.20 (SCLK)
SCL_ISO: ATMEGA328.28 (PC5(ADC5/SCL)), R5.1, SIGNAL_ISOLATOR.10 (I/OB2)
SDA: R3.1, SIGNAL_ISOLATOR.6 (I/OA1), TO_MASTER_BOARD.3
SDA_ISO: ATMEGA328.27 (PC4(ADC4/SDA)), R4.1, SIGNAL_ISOLATOR.11 (I/OB1)
VBUS1: JP1A.2, JP1B.2, VBOX.1, VPANEL.1
VBUS2: F1.1A, F1.1B, VPANEL.2
VREF_2V5: 2V5_VOLTAGE_REF.5 (VOUT_SEN), 2V5_VOLTAGE_REF.6 (VOUT_FORCE), ADC.4 (VREFP), C3.1, C4.1, C5.1, C16.1

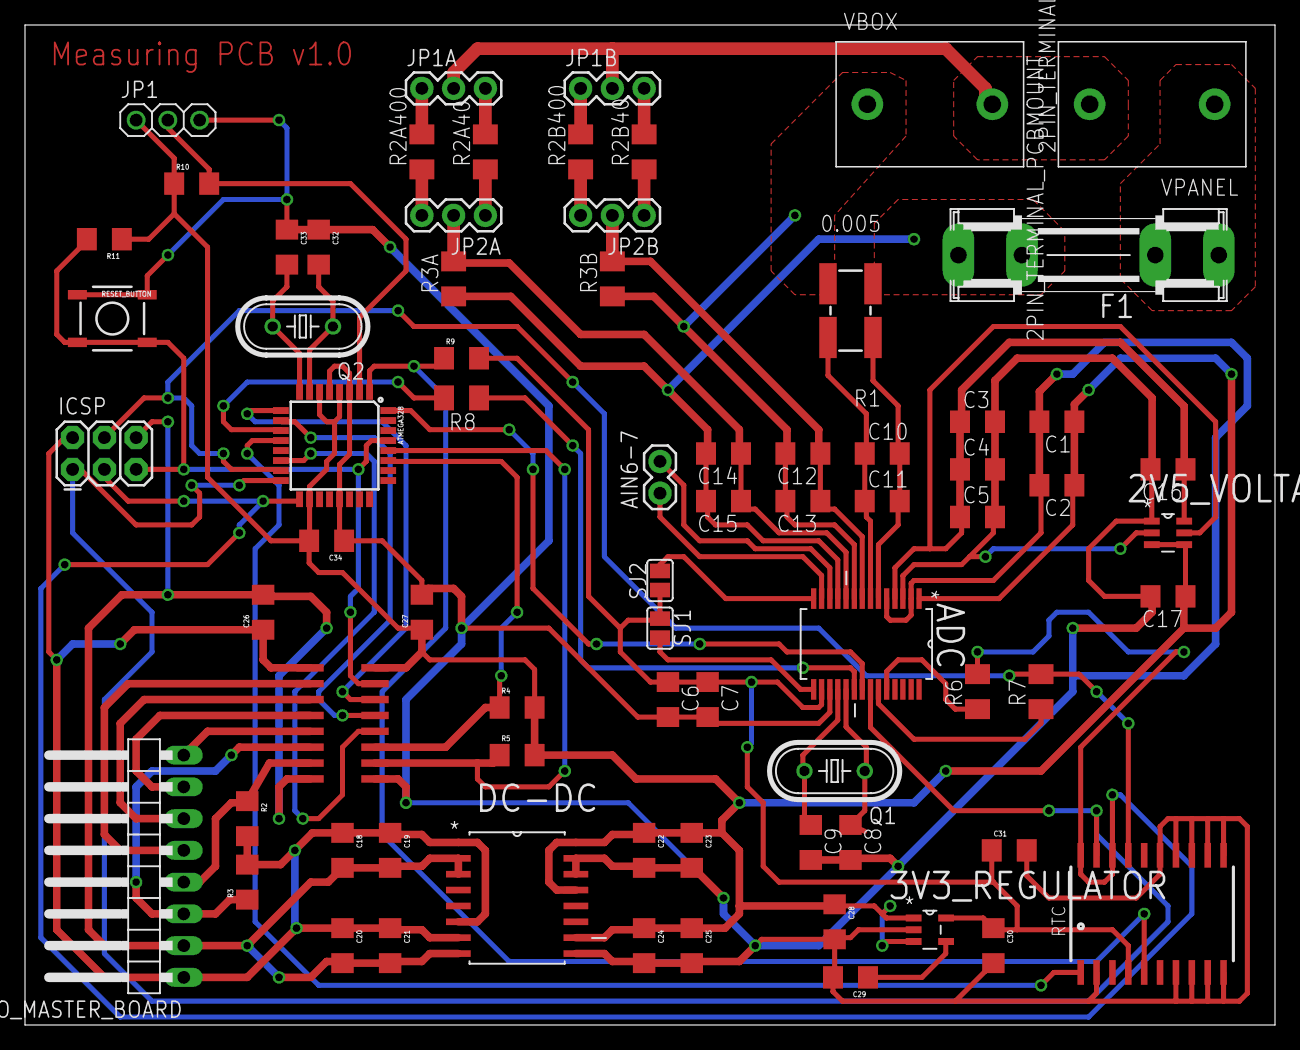
[picture p10: board board1.brd from above]

Board: 2 copper layers, 100.0 x 80.0 mm, 74 parts (0 on the bottom side), 54 nets.
