sideridispas/Measuring-PCB/(commit log)

2016-03-04 Created a schematic file
    [board1.sch]
2016-03-04 Copied the last schematic from demo PCB
    [board1.sch]
2016-03-04 Started modifying the schematic. Changed: jumpers Reset/Sync and 3v3 instead of GND, ADC package, removed R4-R5-C18, label VREFN->BEAGLE_GND
2016-03-04 Added atmega, RTC, ICSP header, Resert button. Organized the schematic with borders
    [DeadOn RTC - DS3234 Breakout-v11.brd, DeadOn RTC - DS3234 Breakout-v11.sch, board1.sch]
2016-03-07 Added connectors, 3v3 regulator. Almost finished the schematic.
    [board1.sch]
2016-03-08 Created the board and placed all the parts. No wires yet
    [board1.brd]
2016-03-08 Started wiring for the first DRAFT version
    [board1.brd]
2016-03-09 Almost finished the first version. I have to finish the current path and check everything
    [board1.brd, board1.sch]
2016-03-18 finished the first draft version of the board
    [board1.brd, board1.sch]
2016-03-18 Created board2 as version 2
    [board2.brd, board2.sch]
2016-03-18 Version2: Placed all parts on the board. Still I have to decide about type of connectors etc and route everything
    [board2.sch]
2016-03-21 Added GND planes and continue working on tracing..
    [board2.brd, board2.sch]
2016-03-21 I think I finished routing
    [board2.brd]
2016-03-21 Small details changed
    [board2.brd]
2016-03-22 added battery for RTC and small changes
    [board2.brd, board2.sch]
2016-03-22 Fixed the fuse footprint
    [board2.brd, board2.sch]
2016-03-22 Added: connector bypassing isolation, mounting holes
    [board2.brd, board2.sch]
2016-03-23 Finished v2.2
    [board2.brd, board2.sch]
2016-03-23 Visual changes and clean up
    [board2.brd, board2.sch]
2016-03-24 Added RX-TX pin jumpers. IMPORTANT: changed the 5V&GND of ICSP connector to the isolated side (after iso)
    [board2.brd, board2.sch]
2016-03-24 Small changes
    [board2.brd]
2016-03-25 Added RX,TX header, D0-3 pinout. Changed the polygon shape (radius in corners). Created first try in 3D for Inventor.
    [1X02, AIN6-7_1X02_9.ipt, 1X02, RX-TX_1X02_110.ipt, 1X03, JP1A_1X03_66.ipt, 1X03, JP1B_1X03_68.ipt, 1X03, JP2A_1X03_70.ipt, 1X03, JP2B_1X03_72.ipt, 2TERMINALBLOCK_10MMPITCH, 2PIN_TERMINAL_PCBMOUNT_116.ipt, 2X04, ISOLATED_CON_2X04_64.ipt]
2016-03-31 Footprints updated and small changes
    [board2.brd, board2.sch]
2016-03-31 IMPORTANT: Changed the terminals for the PV connectors. They are bigger and with double connections
    [board2.brd, board2.sch]
2016-04-05 Updated connectors and schematic. No big changes
    [board2.brd, board2.sch]
2016-04-07 FINAL BOARD AS ORDERED - v2.7
    [board2.brd, board2.sch]
2016-04-11 Only changes in 3D assembly
    [1X02, RX-TX_1X02_119.ipt, 1X02_NO_SILK, AIN6-7_1X02_NO_SILK_9.ipt, 1X03, JP1A_1X03_69.ipt, 1X03, JP1B_1X03_71.ipt, 1X03, JP2A_1X03_73.ipt, 1X03, JP2B_1X03_75.ipt, 1X04_NO_SILK_ALL_ROUND, D0-D3_1X04_NO_SILK_ALL_ROUND_59.ipt, 2X04, ISOLATED_CON_2X04_67.ipt]
